adafruit/Adafruit-LSM303AGR-PCB/Adafruit_LSM303AGR.brd

## EAGLE design Adafruit_LSM303AGR.brd (2019-10-29)

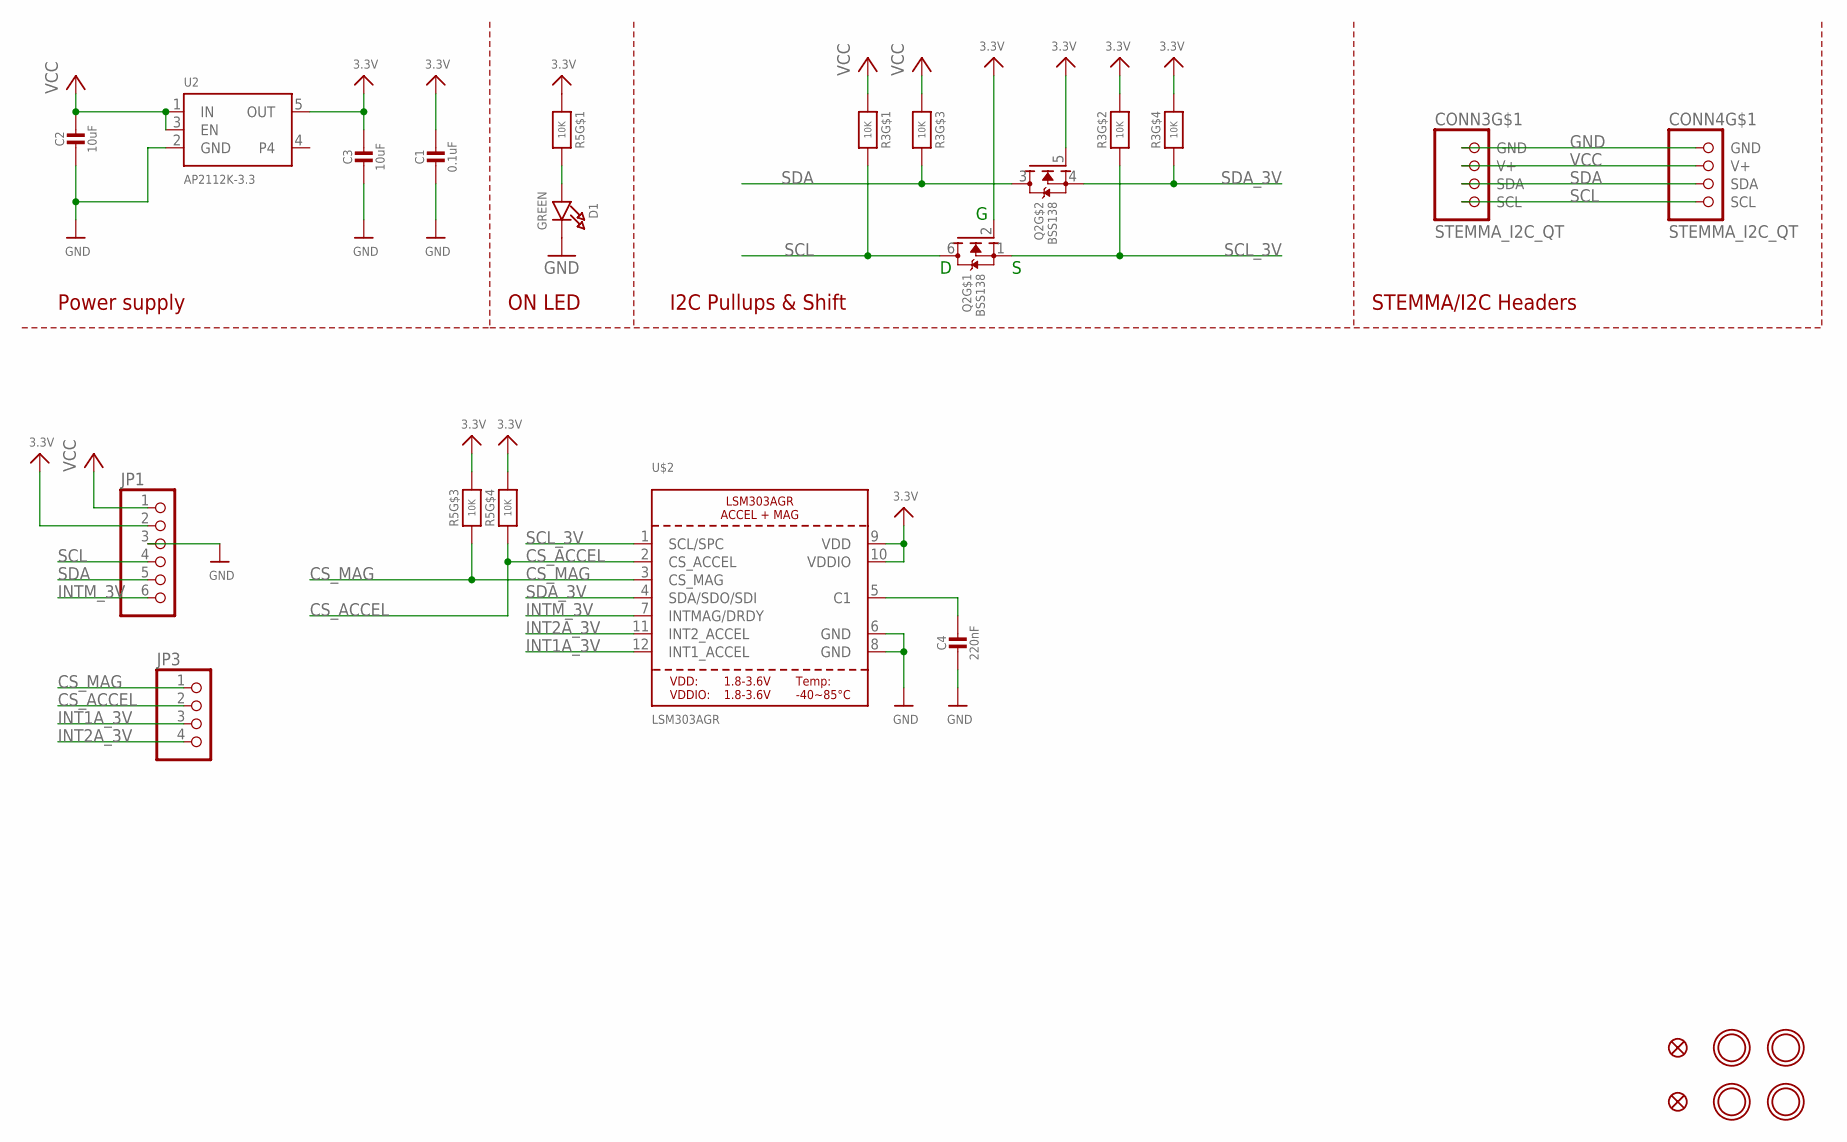
[picture p2: schematic Adafruit_LSM303AGR.sch]

Parts:
C1: 0.1uF; 0603-NO@1
C2: 10uF; 0805-NO
C3: 10uF; 0805_10MGAP
C4: 220nF; 0603-NO@1
CONN3, CONN4: STEMMA_I2C_QT; JST_SH4
D1: GREEN; CHIPLED_0603_NOOUTLINE
FID3, FID4: FIDUCIAL_1MM
JP1: HEADER-1X670MIL; 1X06_ROUND_70
JP3: HEADER-1X4ROUND; 1X04_ROUND
Q2: BSS138; SOT363
R3, R5: 10K; RESPACK_4X0603
U2: AP2112K-3.3; SOT23-5
U$1, U$17, U$19, U$21: MOUNTINGHOLE2.5; MOUNTINGHOLE_2.5_PLATED
U$2: LSM303AGR; LGA12_2X2MM

Connections:
3.3V: C1.1, C3.1, JP1.2, Q2.2 (G), Q2.5 (G), R3.2 (1), R3.4 (1), R5.1, R5.5 (2), R5.6 (2), U2.5 (OUT), U$2.9 (VDD), U$2.10 (VDDIO)
CS_ACCEL: JP3.2, R5.4 (1), U$2.2 (CS_ACCEL)
CS_MAG: JP3.1, R5.3 (1), U$2.3 (CS_MAG)
GND: C1.2, C2.2, C3.2, C4.2, CONN3.1 (GND), CONN4.1 (GND), D1.C, JP1.3, U2.2 (GND), U$2.6 (GND), U$2.8 (GND)
INT1A_3V: JP3.3, U$2.12 (INT1_ACCEL)
INT2A_3V: JP3.4, U$2.11 (INT2_ACCEL)
INTM_3V: JP1.6, U$2.7 (INTMAG/DRDY)
unnamed: D1.A, R5.8 (2)
unnamed: C4.1, U$2.5 (C1)
SCL: CONN3.4 (SCL), CONN4.4 (SCL), JP1.4, Q2.6 (D), R3.8 (2)
SCL_3V: Q2.1 (S), R3.7 (2), U$2.1 (SCL/SPC)
SDA: CONN3.3 (SDA), CONN4.3 (SDA), JP1.5, Q2.3 (D), R3.6 (2)
SDA_3V: Q2.4 (S), R3.5 (2), U$2.4 (SDA/SDO/SDI)
VCC: C2.1, CONN3.2 (V+), CONN4.2 (V+), JP1.1, R3.1, R3.3 (1), U2.1 (IN), U2.3 (EN)

Notes on the sheet:
I2C Pullups & Shift
STEMMA/I2C Headers
ON LED
Power supply

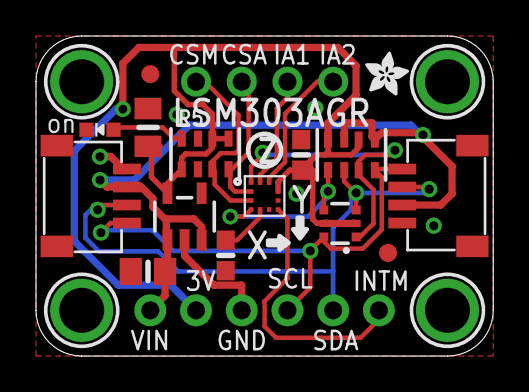
[picture p3: board Adafruit_LSM303AGR.brd from above]

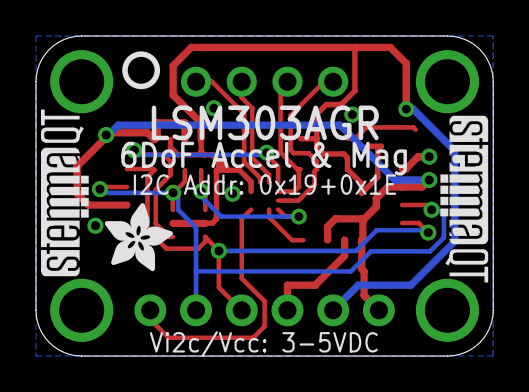
[picture p4: board Adafruit_LSM303AGR.brd from below]

Board: 2 copper layers, 25.4 x 17.8 mm, 25 parts (4 on the bottom side), 14 nets.

Other parts of the board:
U$20: ADAFRUIT_3.5MM
U$25: PCBFEAT-REV-040
U$30, U$31: STEMMAQT
U$40: ADAFRUIT_2.5MM
